d3athstr/pipboy-3000-esp32-fork/reference/photos/941fd944-1b8c-472b-9a88-6c643ce56a46.jpg

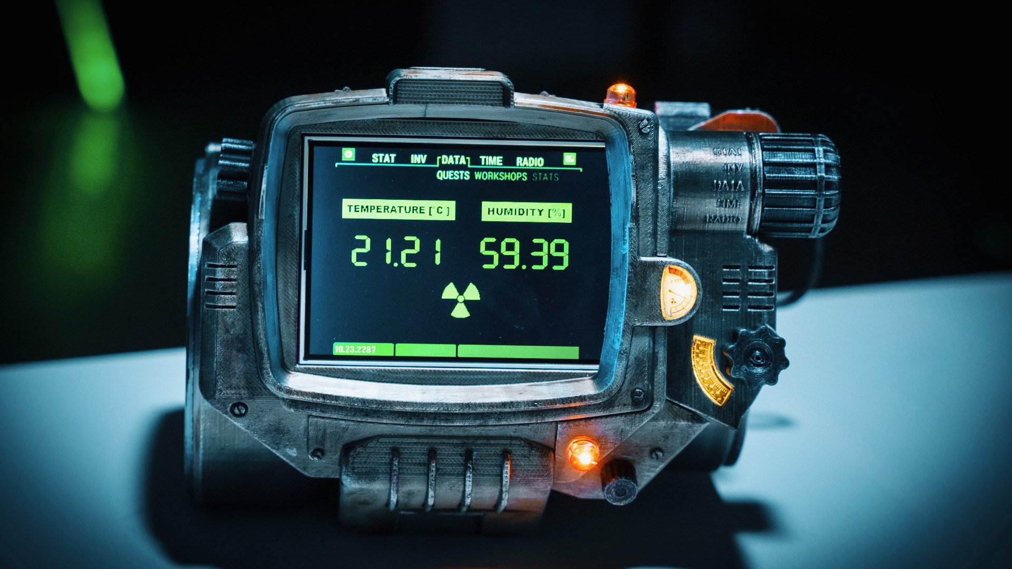
reference/photos/941fd944-1b8c-472b-9a88-6c643ce56a46.jpg
