d3athstr/pipboy-3000-esp32-fork/reference/photos/6dcec5f3-0387-4b51-a163-c64a04e74414.jpg

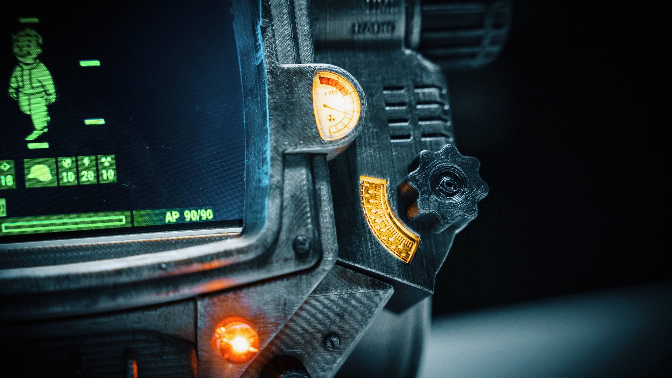
reference/photos/6dcec5f3-0387-4b51-a163-c64a04e74414.jpg
