d3athstr/pipboy-3000-esp32-fork/reference/photos/3f670bc9-0357-48e5-9f1f-739a9425d8e5.jpg

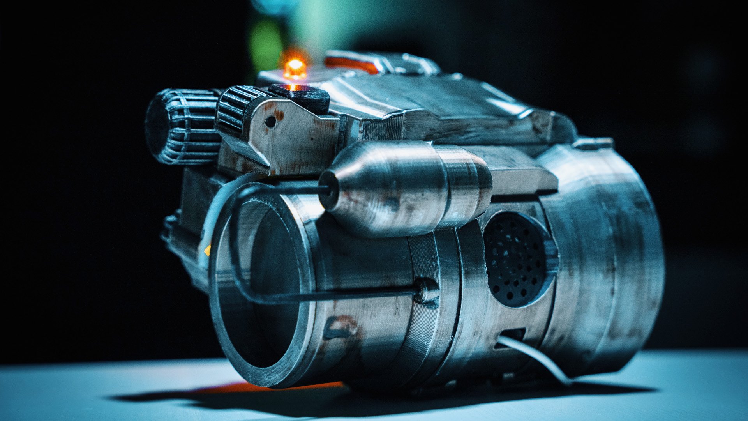
reference/photos/3f670bc9-0357-48e5-9f1f-739a9425d8e5.jpg
