d3athstr/pipboy-3000-esp32-fork/reference/photos/4c812274-ffe6-4be0-b432-a8d1bb93d850.jpg

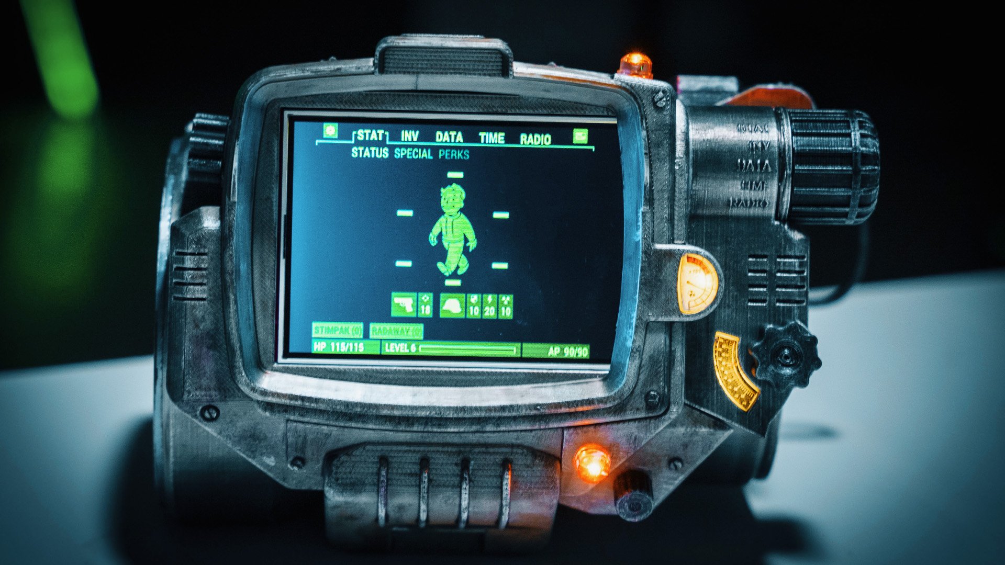
reference/photos/4c812274-ffe6-4be0-b432-a8d1bb93d850.jpg
