d3athstr/pipboy-3000-esp32-fork/reference/photos/6b4683ce-e48f-41a9-b41a-5269c8eccfcf.jpg

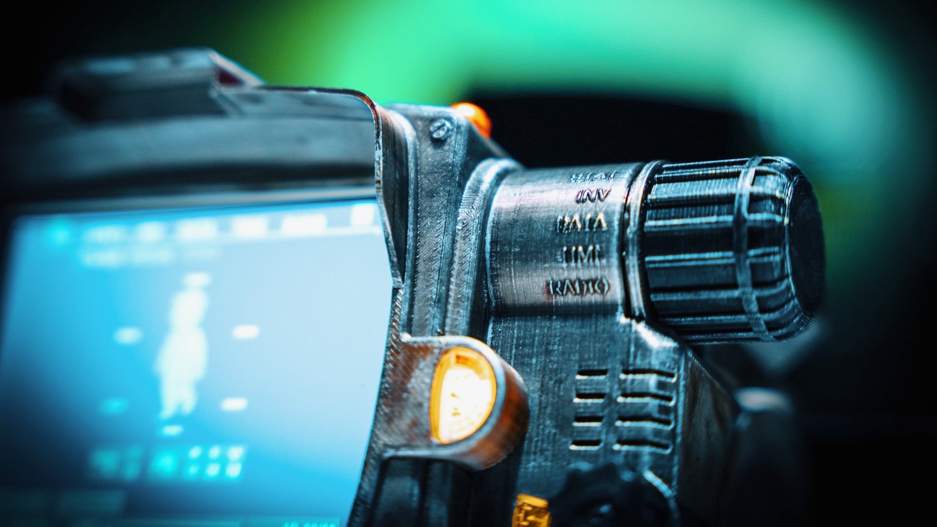
reference/photos/6b4683ce-e48f-41a9-b41a-5269c8eccfcf.jpg
