d3athstr/pipboy-3000-esp32-fork/reference/photos/12c925d4-5342-43e1-9afb-3955cdfec156.png

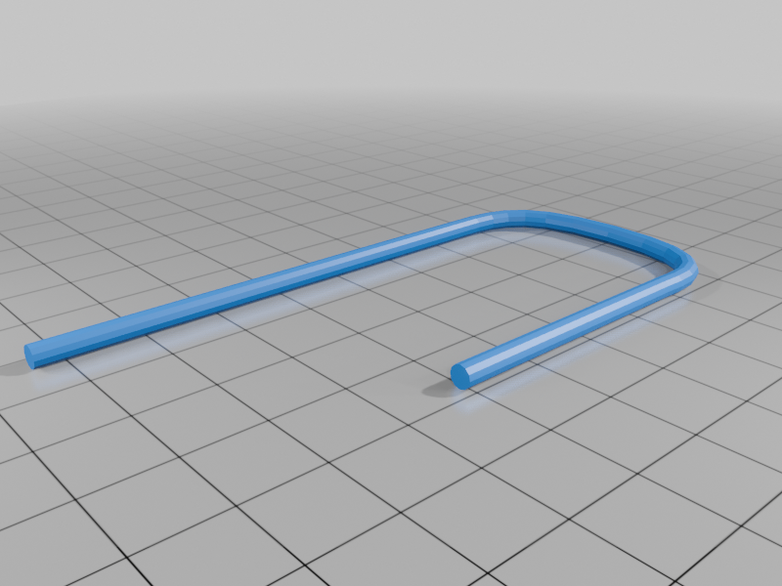
reference/photos/12c925d4-5342-43e1-9afb-3955cdfec156.png
