d3athstr/pipboy-3000-esp32-fork/reference/photos/73d56165-5ab6-4ed1-911e-ac140b90ab1a.jpg

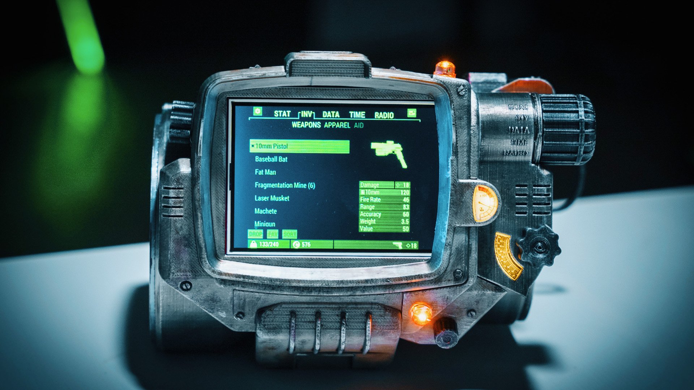
reference/photos/73d56165-5ab6-4ed1-911e-ac140b90ab1a.jpg
