d3athstr/pipboy-3000-esp32-fork/reference/photos/233d7fc1-854f-4d5c-a7f8-5cac9b3d057f.jpg

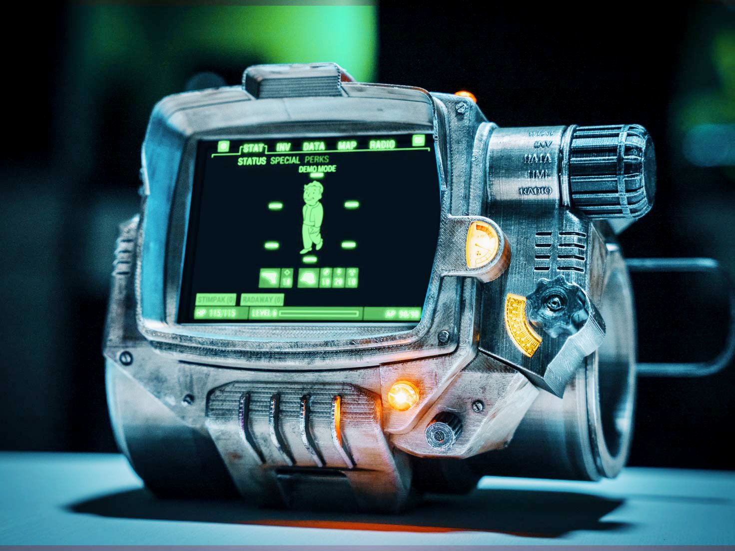
reference/photos/233d7fc1-854f-4d5c-a7f8-5cac9b3d057f.jpg
