d3athstr/pipboy-3000-esp32-fork/reference/photos/4671e049-e326-46cc-a37d-67dcaa47df01.png

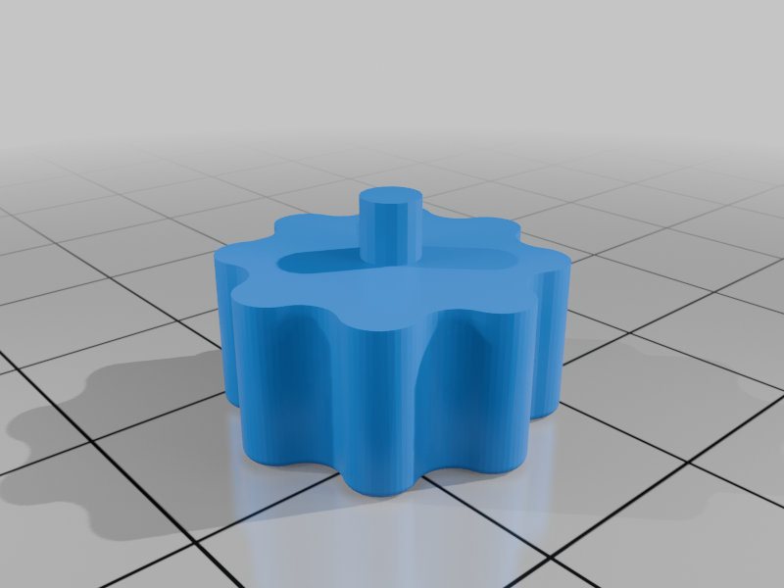
reference/photos/4671e049-e326-46cc-a37d-67dcaa47df01.png
