d3athstr/pipboy-3000-esp32-fork/reference/photos/f01f9e05-2fc1-4a66-958b-b4a19da21b2c.jpg

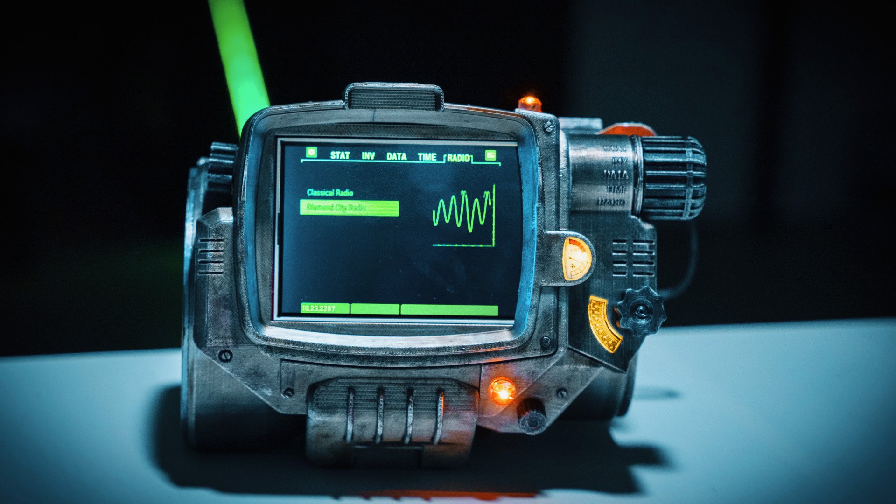
reference/photos/f01f9e05-2fc1-4a66-958b-b4a19da21b2c.jpg
