d3athstr/pipboy-3000-esp32-fork/reference/photos/fd568031-6ef1-42b2-a4bd-773df9426be3.jpg

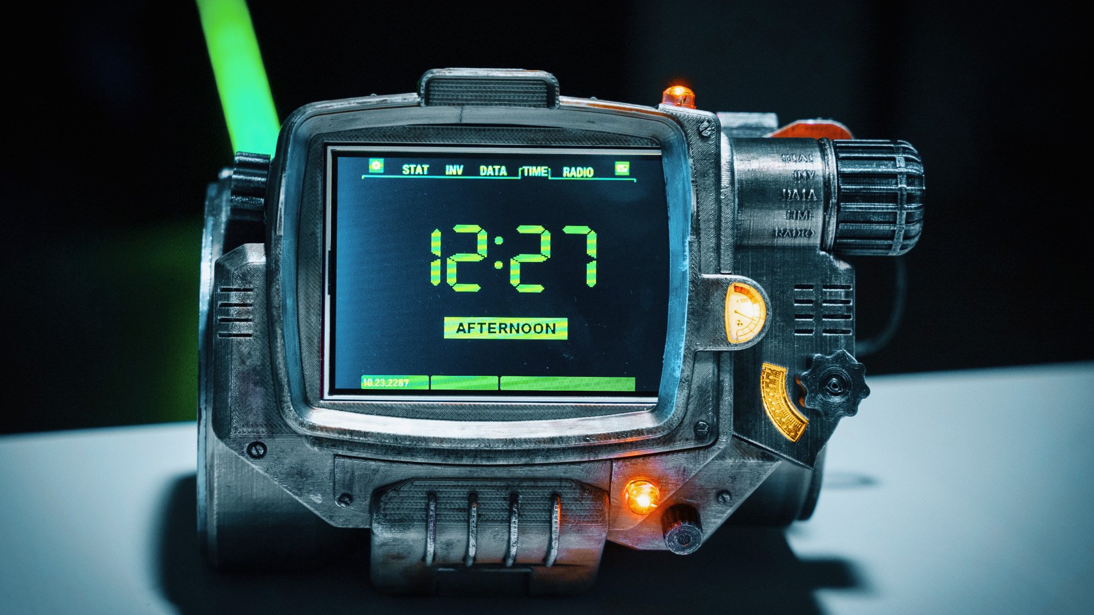
reference/photos/fd568031-6ef1-42b2-a4bd-773df9426be3.jpg
