d3athstr/pipboy-3000-esp32-fork/stl/PipBoy_3000_Tune_and_side_buttons.STL

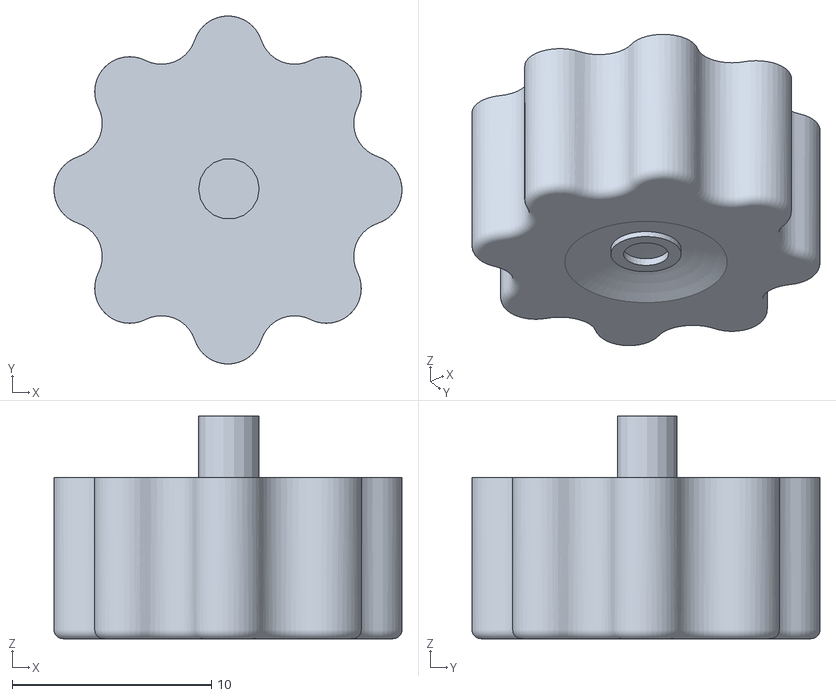
[picture p12: CAD file, 2026-07-08]
stl/PipBoy_3000_Tune_and_side_buttons.STL
17.5 x 17.5 x 11.2
