d3athstr/pipboy-3000-esp32-fork/stl/PipBoy_3000_Geiger.stl

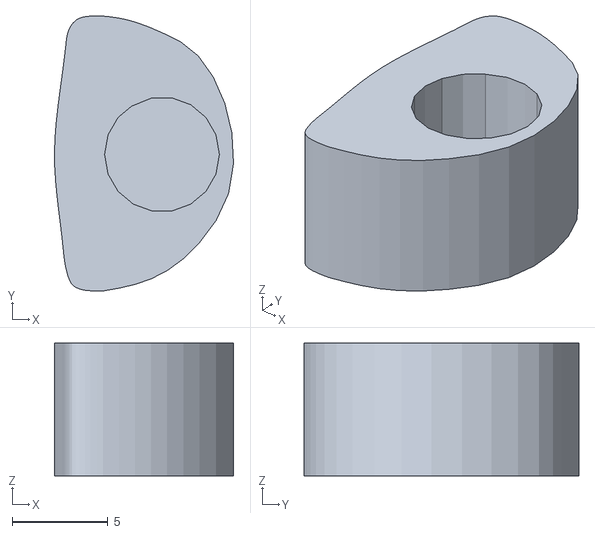
[picture p13: CAD file, 2026-07-08]
stl/PipBoy_3000_Geiger.stl
9.33 x 14.3 x 6.91
