d3athstr/pipboy-3000-esp32-fork/stl/PipBoy_3000_Wire.stl

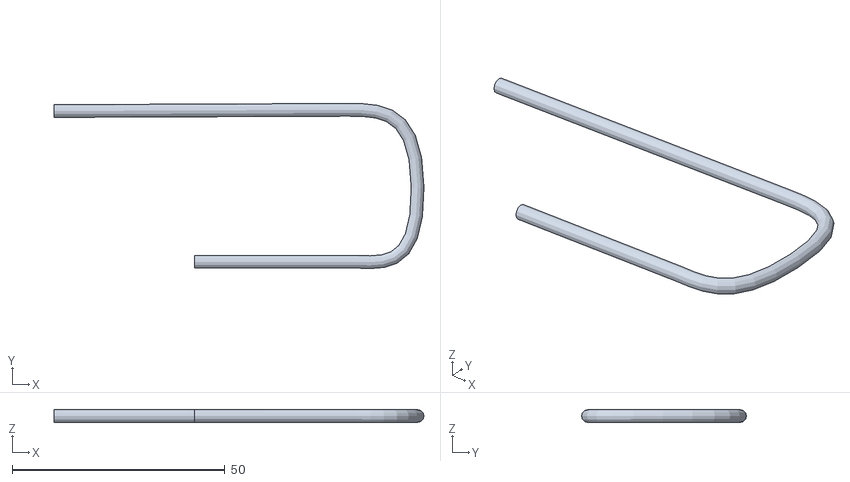
[picture p14: CAD file, 2026-07-08]
stl/PipBoy_3000_Wire.stl
86.9 x 38.8 x 3.06
