d3athstr/pipboy-3000-esp32-fork/stl/PipBoy_3000_Back.stl

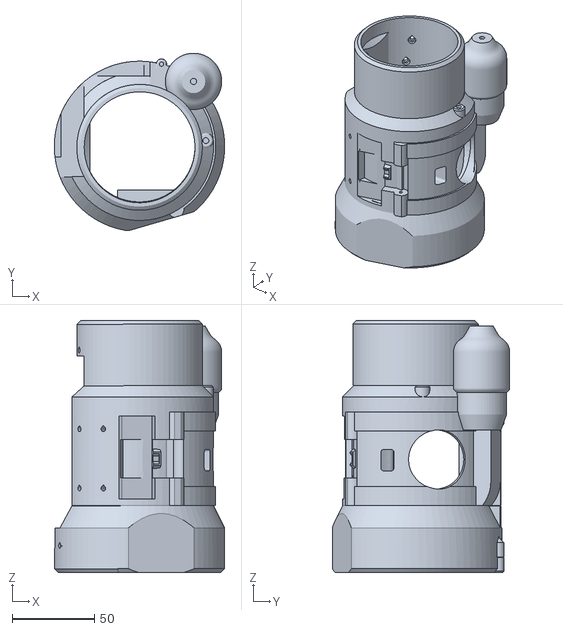
[picture p15: CAD file, 2026-07-08]
stl/PipBoy_3000_Back.stl
103.5 x 107.8 x 153.1
