d3athstr/pipboy-3000-esp32-fork/stl/PipBoy_3000_Select_button.stl

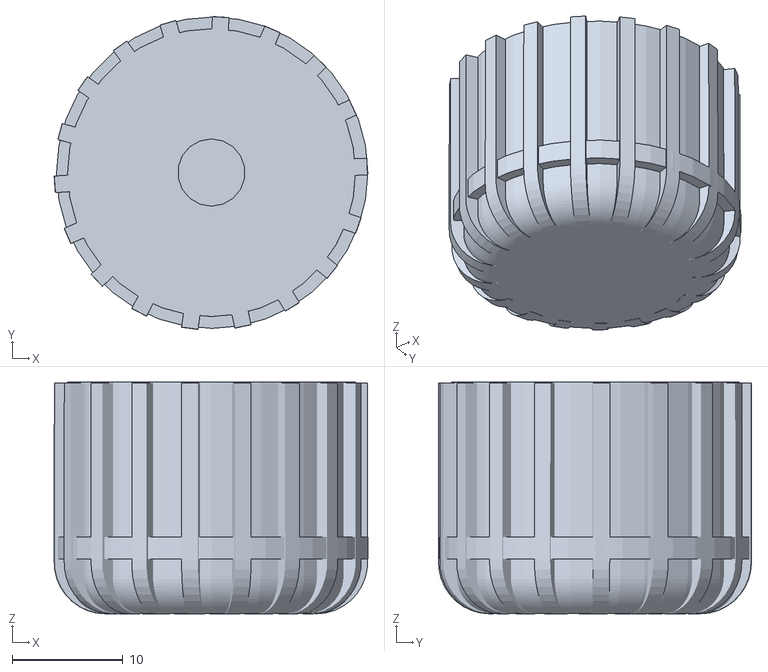
[picture p16: CAD file, 2026-07-08]
stl/PipBoy_3000_Select_button.stl
28.3 x 28.3 x 20.9
