d3athstr/pipboy-3000-esp32-fork/stl/PipBoy_3000_Front.stl

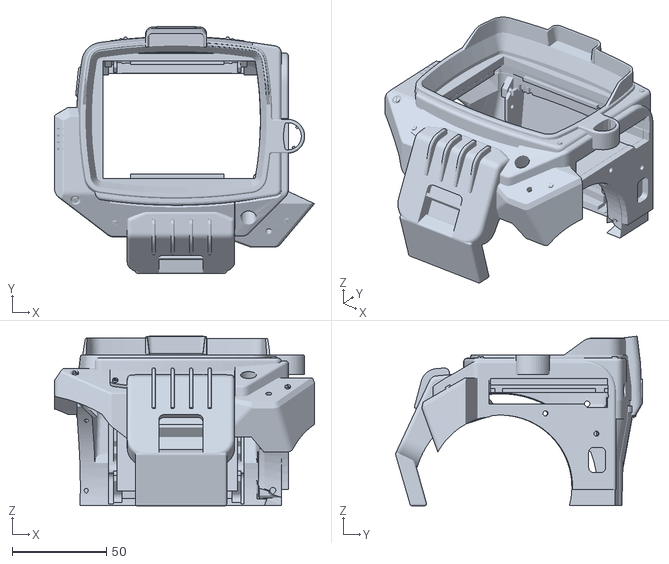
[picture p17: CAD file, 2026-07-08]
stl/PipBoy_3000_Front.stl
138.1 x 131.0 x 90.2
