d3athstr/pipboy-3000-esp32-fork/stl/PipBoy_3000_Right_cap.stl

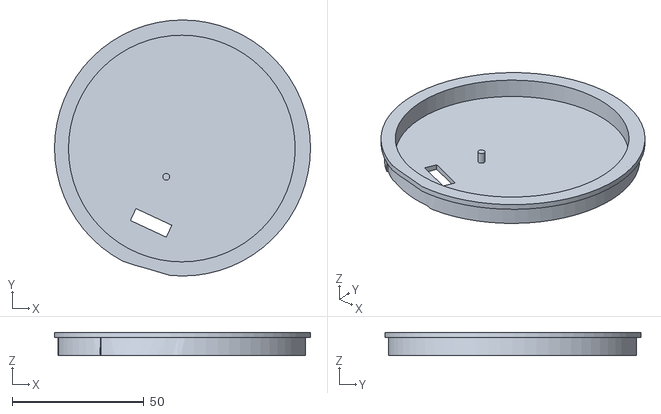
[picture p18: CAD file, 2026-07-08]
stl/PipBoy_3000_Right_cap.stl
97.1 x 97.1 x 8.89
