d3athstr/pipboy-3000-esp32-fork/stl/PipBoy_3000_Tune.stl

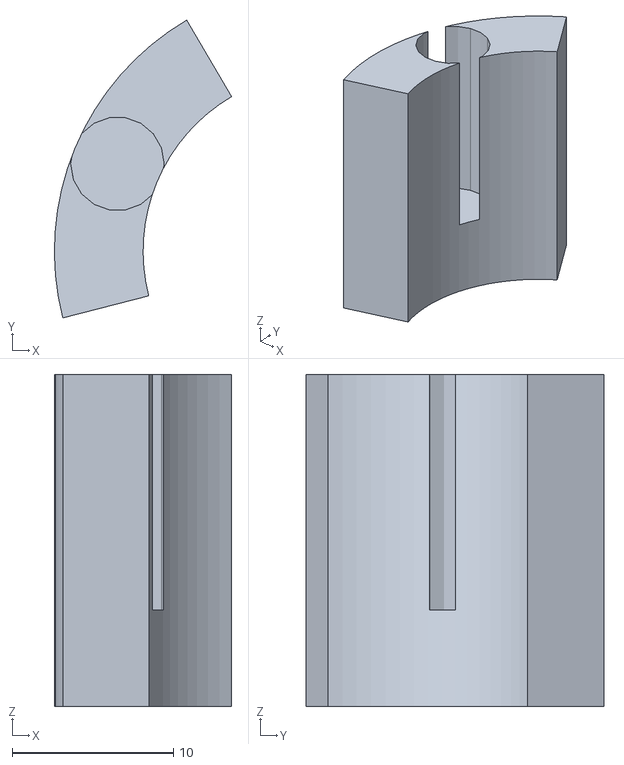
[picture p19: CAD file, 2026-07-08]
stl/PipBoy_3000_Tune.stl
11.0 x 18.5 x 20.6
