d3athstr/pipboy-3000-esp32-fork/stl/PipBoy_3000_Low_button.STL

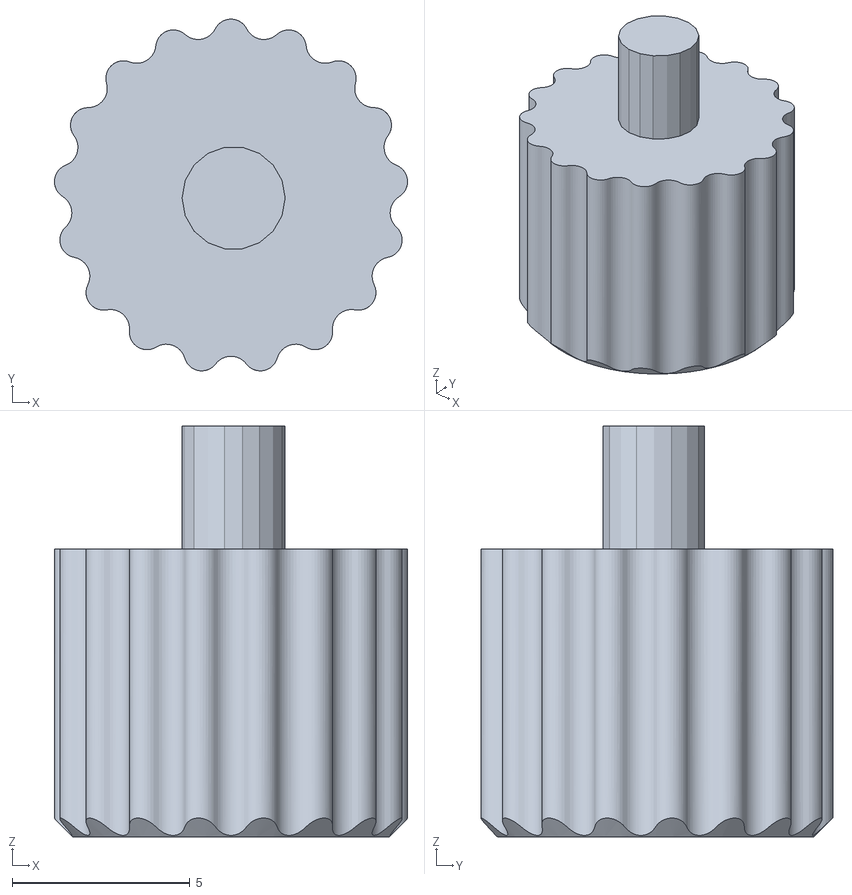
[picture p20: CAD file, 2026-07-08]
stl/PipBoy_3000_Low_button.STL
9.94 x 9.90 x 11.6
