d3athstr/pipboy-3000-esp32-fork/stl/PipBoy_3000_Side.stl

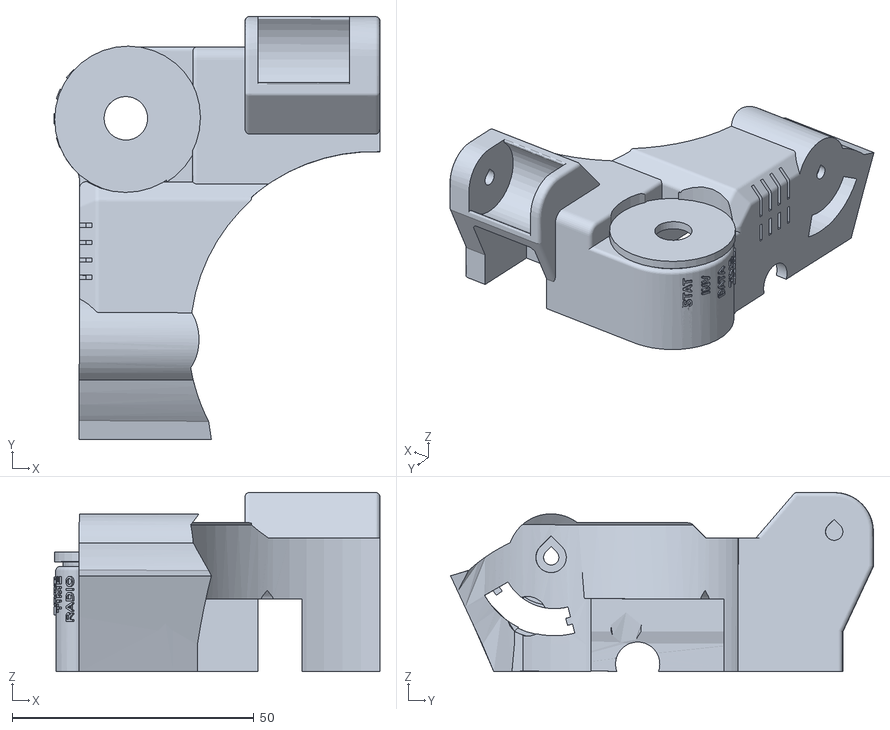
[picture p21: CAD file, 2026-07-08]
stl/PipBoy_3000_Side.stl
67.4 x 87.5 x 37.0
