d3athstr/pipboy-3000-esp32-fork/stl/PipBoy_3000_Rotary_1.STL

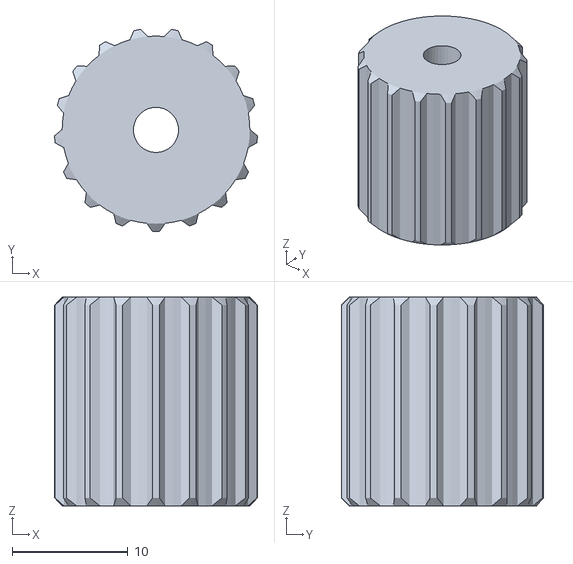
[picture p22: CAD file, 2026-07-08]
stl/PipBoy_3000_Rotary_1.STL
17.5 x 17.5 x 18.0
