d3athstr/pipboy-3000-esp32-fork/stl/PipBoy_3000_Top_button.stl

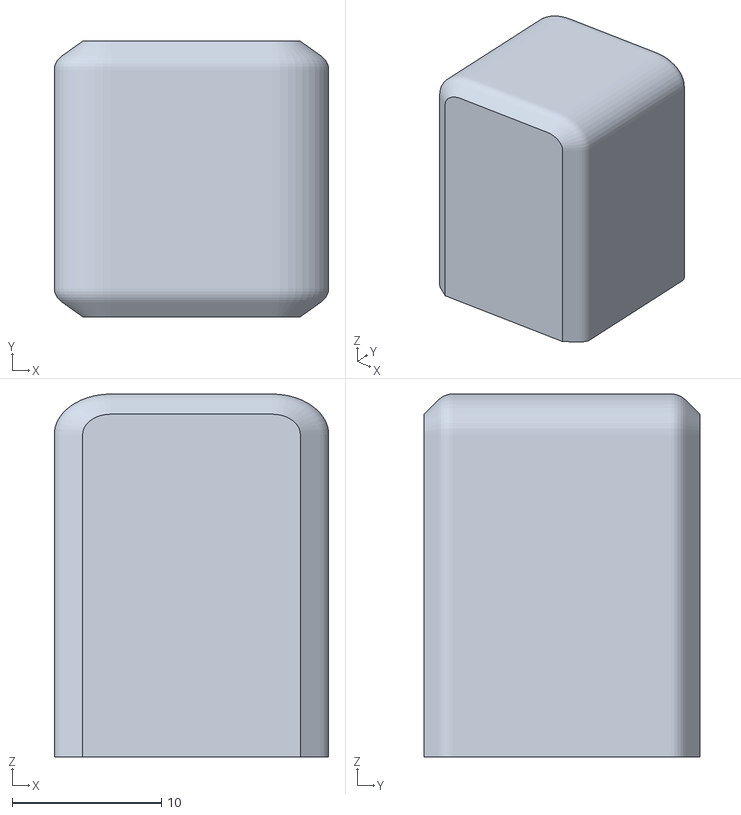
[picture p23: CAD file, 2026-07-08]
stl/PipBoy_3000_Top_button.stl
18.4 x 18.4 x 24.3
