d3athstr/pipboy-3000-esp32-fork/stl/PipBoy_3000_.stl

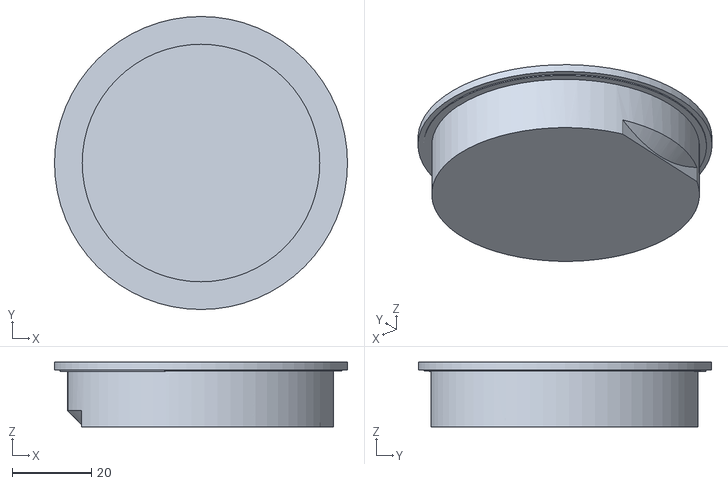
[picture p24: CAD file, 2026-07-08]
stl/PipBoy_3000_.stl
73.9 x 73.9 x 16.3
