d3athstr/pipboy-3000-esp32-fork/stl/PipBoy_3000_Rotary_1_axle.STL

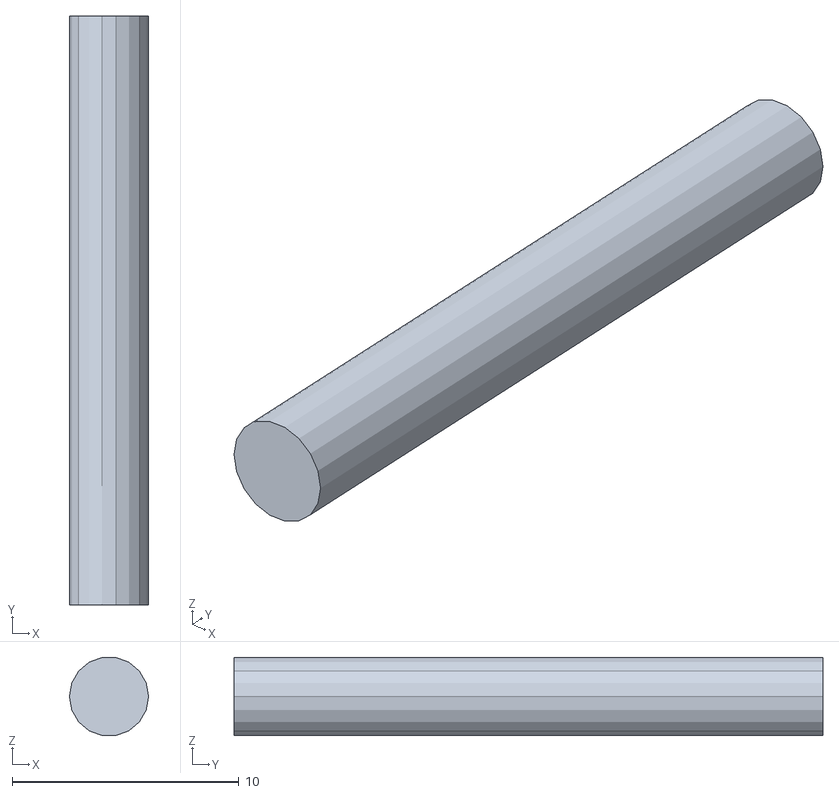
[picture p25: CAD file, 2026-07-08]
stl/PipBoy_3000_Rotary_1_axle.STL
3.50 x 26.0 x 3.45
