d3athstr/pipboy-3000-esp32-fork/(commit log)

2026-07-08 PipBoy 3000 ESP32 fork — v1 fixes + v2 ESP32-S3 firmware
    Fork of jeje95's PipBoy 3000 ESP32 (thingiverse.com/thing:6654866).
    v1: unified/fixed port of the upstream sketches (classic ESP32).
    v2: ESP32-S3 — non-blocking screen engine, phone hotspot control page,
    DS3231 RTC timekeeping, MAX17048 HP bar, LED PWM effects, OTA.
    Includes STLs, BOM, wiring diagrams (text + SVG), SD-card notes.
    [PipBoy_3000_.stl, PipBoy_3000_Back.stl, PipBoy_3000_Front.stl, PipBoy_3000_Geiger.stl, PipBoy_3000_Low_button.STL, PipBoy_3000_Right_cap.stl, PipBoy_3000_Rotary_1.STL, PipBoy_3000_Rotary_1_axle.STL]
2026-07-11 Add DISPLAY_ENABLED headless bring-up mode; flash verified on hardware
    First hardware flash (ESP32-S3 on RAZORCREST) boot-looped: tft.begin()
    faults in spi.beginTransaction() because the TFT_eSPI config can't be
    validated until the real panel is wired. Added a DISPLAY_ENABLED compile
    switch (default 1) that skips all TFT hardware when 0, so the board boots
    to hotspot + OTA headless. Verified: DISPLAY_ENABLED=0 build boots clean,
    brings up PIPBOY3000 / 192.168.4.1, peripherals degrade gracefully.
    Both DISPLAY_ENABLED 0 and 1 compile. Display config to be finalized when
    the panel is wired, then pushed via OTA.
    [PipBoy3000-S3.ino]
2026-07-11 TFT config: ILI9486 + USE_HSPI_PORT (fixes tft.begin boot-loop)
    Don confirmed the panel is ILI9486. Root-caused the earlier tft.begin()
    crash: on ESP32-S3 TFT_eSPI shares the global SPI object by reference and
    spi.beginTransaction() derefs a null bus. USE_HSPI_PORT gives it a dedicated
    port. Driver ST7796->ILI9486, SPI 40->20MHz (ILI9486-safe). DISPLAY_ENABLED=1
    build verified on hardware: boots clean past tft.begin, hotspot+OTA live.
    Added TFT_eSPI_Setup_PipBoy.h for Arduino-IDE users.
    [TFT_eSPI_Setup_PipBoy.h]
2026-07-11 Docs: ILI9486 + 20MHz across wiring/BOM; clarify panel not yet wired
    Wiring diagram (text + SVG) and BOM now name ILI9486 and 20MHz SPI to match
    the firmware config. README on-board-firmware note corrected: the clean boot
    only proves the SPI config doesn't crash into an unconnected bus; pixel output
    is unverified until the panel is wired.
2026-07-12 WIRING: replace power tree with point-to-point build-order guide
    Terminal-to-terminal connection tables per stage (battery/charge -> switch/
    boost -> 5V loads -> 3.3V loads -> common ground), with meter-check gates.
    Corrects the MAX17048 rail: it senses the RAW cell (before switch/boost),
    not a flat 3.3V VCC; logic-supply pin is board-dependent (resolve when the
    gauge arrives). Adds USB-vs-battery bench-power caution.
2026-07-12 Power: switch to Adafruit PowerBoost 500C (charger+boost); switch on EN
    Don's board is the PowerBoost 500C (#1944), not a bare TPS61090 — it charges
    the LiPo and boosts to 5.2V in one board, so the TP4056 is dropped. Power
    switch goes on the EN pin (EN-GND=off / EN-BAT=on), per the Adafruit guide;
    carries no load current. Updated WIRING.md (point-to-point + current budget +
    LBO-not-3.3V-safe note + PowerBoost bench-power caution), BOM, and the SVG
    power tree. MAX17048 now taps the PowerBoost BAT pad.
2026-07-12 WIRING: fix bring-up step 5 for PowerBoost 500C
2026-07-13 Display bring-up: migrate to LovyanGFX; document the full saga
    TFT_eSPI 2.5.43 can't drive SPI on the ESP32-S3 + arduino-esp32 3.x core
    (crashes or silent no-output), so the display layer was ported to LovyanGFX
    (lgfx_pipboy.h; GIFDraw needed one line). Added platformio.ini for a
    reproducible build and a /api/status build-ID field to confirm OTAs land.
    Display still NOT working (solid grey) after ruling out: power, 2 libraries,
    3 drivers, multiple clocks, the harness, 3 screens, and the ESP32 board
    (replaced, new MAC 84:fc:e6:5e:67:58). Leading hypothesis: panel-side LCD vs
    touch vs SD pin mapping. Full history + next steps in DISPLAY-BRINGUP-LOG.md.
    New screen on order. Everything else (po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
    [GIFDraw.ino, PipBoy3000-S3.ino, lgfx_pipboy.h]
2026-07-14 Fix control page: radio/stop buttons must POST, not GET
    The RADIO and STOP buttons called api(url) with no options -> fetch() GET,
    but /api/play and /api/stop are HTTP_POST handlers, so the buttons silently
    did nothing (volume worked because it correctly POSTed). Added {method:'POST'}.
    [PipBoy3000-S3.ino]
2026-07-14 Docs: LED channel (2N3904/3 LEDs), DFPlayer cap, network re-onboard, radio fix
    - WIRING.md: as-built LED channel (2N3904 low-side, 3 LEDs) + DFPlayer 470uF
    cap polarity; pin-table GPIO21 note.
    - bom.txt: 2N3904 LED driver; ESP32 network re-onboarded (new MAC → .15.60).
    - DISPLAY-BRINGUP-LOG.md: network re-onboarding DONE, radio fix, SHT31 back.
    - README: build-status refresh (radio works; on .15.60/pipboy.empire12.net).
2026-07-15 Display: set driver to ILI9488 (confirmed panel), remove read-ID diagnostics
    Amazon listing confirms the panel is a Haldzemo 3.5" 480x320 ILI9488 (not the
    ILI9486 we'd assumed). Set Panel_ILI9488, back to SPI2_HOST / normal read clock
    / no MISO. Removed the temporary panel-ID read instrumentation.
    Display still not lit: read-ID diagnostic showed the controller returns 0x0
    (no SPI response) even at 2MHz on both SPI hosts, with correct driver + good
    power + confirmed LCD pins — i.e. the SPI link is physically down (short
    between lines or a cold joint on SCK/MOSI/DC/CS). Hardware, not firmware.
    [PipBoy3000-S3.ino, lgfx_pipboy.h]
2026-07-15 Display WORKING: ILI9488 + setSwapBytes(false) + 8MHz; Celsius; final config
    The display is fully solved. Final config:
    - Panel_ILI9488, SPI2_HOST, pins 10-14, rgb_order=false
    - setSwapBytes(false) — GIF pixels were byte-scrambled (green showed as
    red/blue); flipping endianness fixes the colors. rgb_order/manual R-B swap
    were both wrong turns.
    - freq_write 8MHz — higher clocks corrupt the image into diagonal lines on
    this hand-soldered/matrix-routed wiring; 8MHz renders complete frames.
    - USE_FAHRENHEIT commented out -> Celsius.
    Kept a knob/screen field in /api/status for verifying the rotary switch.
    Root cause of the long saga was hardware: a reverse-battery-damaged PowerBoost
    (3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
    [PipBoy3000-S3.ino, lgfx_pipboy.h]
2026-07-15 Docs: mark display SOLVED (ILI9488/8MHz/setSwapBytes-false)
    DISPLAY-BRINGUP-LOG resolved section, README status, bom.txt. Root cause was
    the reverse-battery-damaged PowerBoost (3.15V) + a loose SPI joint.
2026-08-20 Docs: MAX17048 as-counted pinout, correct "phased" status
    Boards have been on hand since 2026-08-20 (7 pcs, PartsBin [91]) but every
    doc still said "not on hand yet".
    Pinout is the 8-pin clone header + - SDA SCL QST VCC GND ALT as counted on
    the board, NOT Adafruit 5580 labelling -- there is no BAT pad.
    + -> PowerBoost BAT pad (raw cell)
    -, GND -> ground rail
    VCC -> ESP32-S3 3V3, NOT the cell (pullups would idle at ~4.2 V,
    over GPIO8/9's 3.6 V absolute max)
    SDA / SCL -> GPIO8 / GPIO9
    QST, ALT -> unconnected
    The MAX17048 is a ModelGauge part: voltage only, no sense resistor, so pack
    current need not flow through it -- in-line and tapped are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
2026-08-20 Diagram: add MAX17048 8-pin detail block, correct TFT to solved config
    wiring-diagram.svg:
    - New bottom block showing the gauge header as counted (+ - SDA SCL QST VCC
    GND ALT) with each pin's destination, plus the VCC-on-3V3 warning and the
    ModelGauge note.
    - TFT block corrected to the 2026-07-15 solved config: 3.5" ILI9488 /
    LovyanGFX / 8 MHz (was 4" ILI9486 / write-only / 20 MHz).
    - Canvas 1010 -> 1240; footer moved below the new block, dated 2026-08-20.
    Claude-Session: https://claude.ai/code/session_01PMhsWr11b1yfCYJZPs38in
2026-08-20 Docs: battery leads land on the PowerBoost; drop the in-line option
    This module has a single +/- pair, not a pass-through pair like Adafruit's
    two-JST boards, so the gauge is a tap and cannot be wired in-line. The
    earlier in-line/tap framing was wrong for this board.
    Both battery leads go to the PowerBoost (BAT / GND); the gauge takes a thin
    sense wire off the same two nodes and carries no load current. Also records
    that the JST 1.25mm cell does not mate with the PowerBoost's JST-PH 2.0, so
    the leads should be soldered to the BAT/GND pads -- metered first.
    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
2026-08-20 Docs: in-line build restored — both boards have a JST, same PH 2.0 size
    Correcting the previous commit. The gauge is not a sense-only single pair:
    it has a JST battery port whose net is the +/- header, and the PowerBoost's
    JST is the same PH 2.0 size, so the two mate and the cell can run in-line
    (LiPo -> gauge -> PowerBoost) as well as tapped. Both are the same circuit.
    The cell [12] is JST 1.25mm, so it is the one that needs re-terminating or
    an adapter. Added the continuity check (gauge JST + pin vs header + pad)
    that distinguishes a pass-through header from a sense-only input, and made
    the pin table arrangement-agnostic.
    VCC still comes from the ESP32 3V3 in both builds, never from th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
2026-08-20 Docs: state explicitly that the 5V side is unchanged by the gauge
    5Vo keeps feeding ESP32 5V/VIN, DFPlayer, TFT and the LED anodes as-is; EN
    switch and USB charging untouched. The only power-chain change is upstream of
    the PowerBoost. Also warns against feeding gauge VCC from the 5V rail (pullups
    would idle at 5V, past GPIO8/9's 3.6V max) and notes the gauge stays powered
    with EN off since it sits on the cell side (~3uA hibernate).
    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
2026-08-21 Firmware v5.1-gauge: generic MAX1704x driver + I2C diagnostics
    Adafruit_MAX1704X::begin() hard-requires (VERSION & 0xFFF0) == 0x0010, so it
    refuses a MAX17043/44 outright even when the part answers at 0x36. PartsBin
    [91] deliberately covers both families, so the fitted board may be either.
    Replaced it with fuelgauge.h, a direct-register driver that accepts both and
    picks VCELL scaling from the VERSION register (78.125uV/LSB 16-bit for the
    17048/49, 1.25mV/LSB 12-bit left-aligned for the 17043/44). SOC is 1/256% on
    both. Same method names, so drawBattery() and the status JSON are unchanged.
    Added diagnostics so this is debuggable without a serial cable:
    - /api/status gains gauge, gauge_ver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
    [PipBoy3000-S3.ino, fuelgauge.h]
2026-08-21 Docs: VCC is cell-derived on this clone -- do NOT wire it to 3V3
    Found on hardware 2026-08-20. Wiring the gauge's VCC to the ESP32 3V3 backfed
    the cell into the 3.3 V rail: the EN switch stopped turning the PipBoy off
    (cell reaches the ESP32 around the boost) and the gauge never appeared at
    0x36. ~4.2 V on 3V3 is over the ESP32-S3's 3.6 V absolute max and back-drives
    its LDO -- and the first ESP32-S3 on this build was already replaced for
    suspected damage.
    The MAX17048 die is powered from CELL, its only supply pin, so on a minimal
    clone the VCC pad is cell-derived -- a battery-voltage output like Adafruit's
    Bat pin, not a logic supply input. Adafruit's board has a genuine separate
    VIN; this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
2026-08-21 Firmware v5.2-gauge: runtime re-probe; gauge WORKING (MAX17043, ver 0x0003)
    fuelTick() re-probes every 5s while !fuelOK, so a gauge fitted or repaired
    with the PipBoy running is picked up without a power cycle. Until now "plug
    it in later, no reflash needed" still cost a reboot.
    Gauge is live: batt 29%, 3.65V, VERSION 0x0003 -> the fitted board is a
    MAX17043, so Adafruit_MAX1704X would have refused it even after the wiring
    was fixed. Both faults were real and independent:
    1. VCC strapped to the ESP32 3V3 backfed the cell and kept it off the bus
    2. the library's version gate would have left the HP bar dark anyway
    Corrected the fuelgauge.h comment: (raw >> 4) * 1.25e-3 == raw * 78.125e-6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
    [PipBoy3000-S3.ino, fuelgauge.h]
2026-08-21 Docs: gauge is fitted and working -- record the as-built state
    WIRING.md section retitled "FITTED AND WORKING", VCC row changed to LEAVE
    UNCONNECTED, the meter-first warning replaced with the resolved outcome, and
    the MAX17043 note rewritten: the firmware no longer uses Adafruit_MAX1704X
    (its version gate refuses 0x0003) and must not be "simplified" back to it.
    Added a diagnostics section: /api/status now carries gauge, gauge_ver and
    i2c; /api/i2cscan rescans live while reflowing. Records the healthy bus as
    0x36,0x44,0x57,0x68 and that 0x57 is the DS3231 module's AT24C32 EEPROM, not
    a stray device. Notes the v5.2 runtime re-probe.
    bom.txt, README.md and wiring-diagram.svg brought to the sa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
2026-08-22 Fix clock timezone: TZ_INFO CST6CDT -> EST5EDT
    The web UI "sync clock from this phone" button was reported as not
    working. It was working -- the clock set correctly every time, but
    TZ_INFO still carried the v1 sketch's US Central default, so the time
    rendered one hour behind US Eastern and read as "won't set".
    All time is stored as UTC (settimeofday + rtc.adjust(DateTime(epochUTC)));
    TZ_INFO only controls display, so the automatic NTP sync in wifiTick()
    was equally affected -- hand-setting it could never have stuck.
    DST rules (M3.2.0,M11.1.0) were already correct US rules, unchanged.
    README documents TZ_INFO as a compile-time knob and this failure mode.
    v1 fallback sketch keeps CST6CDT (n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
    [PipBoy3000-S3.ino]
2026-08-22 Fix v1 fallback sketch timezone too: CST6CDT -> EST5EDT
    Follows d552b5e, which fixed only the v2/S3 firmware. The v1 classic-ESP32
    fallback carried the same Central default, so falling back to it would have
    reproduced the same "clock won't set" symptom.
    Both sketches are now EST5EDT,M3.2.0,M11.1.0; no CST6CDT remains in the tree.
    [PipBoy3000.ino]
